Saransh-Gupta17/Bristol-SEDS-Rocketry-Simulation/CAD/Recovery system CAD/Recovery systems/Avionics bay.SLDPRT

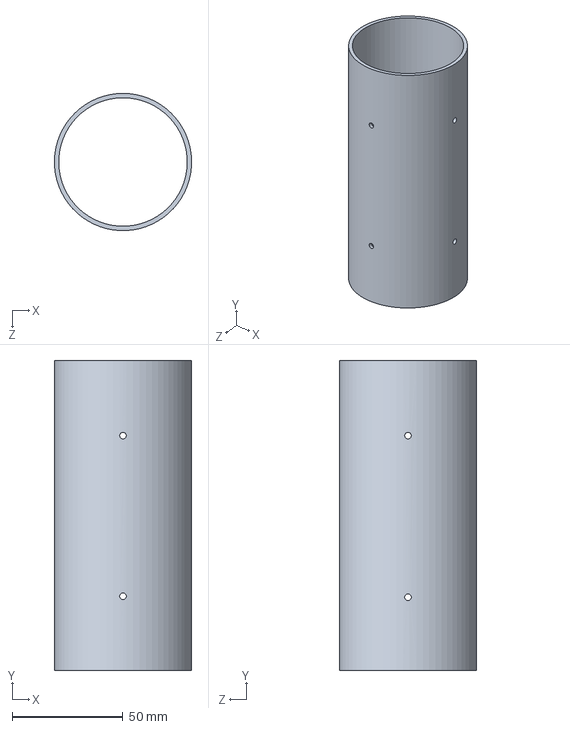
[picture p21: CAD file, 2026-06-27]
CAD/Recovery system CAD/Recovery systems/Avionics bay.SLDPRT
62.0 x 140.0 x 62.0 mm
