Saransh-Gupta17/Bristol-SEDS-Rocketry-Simulation/CAD/Recovery system CAD/Recovery systems/Forward buckhead.SLDPRT

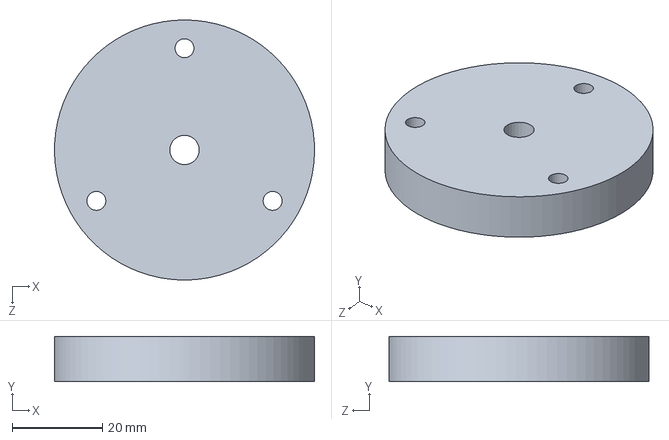
[picture p22: CAD file, 2026-06-27]
CAD/Recovery system CAD/Recovery systems/Forward buckhead.SLDPRT
57.5 x 10.0 x 57.5 mm
