Saransh-Gupta17/Bristol-SEDS-Rocketry-Simulation/CAD/Recovery system CAD/Recovery systems/Part file.STEP

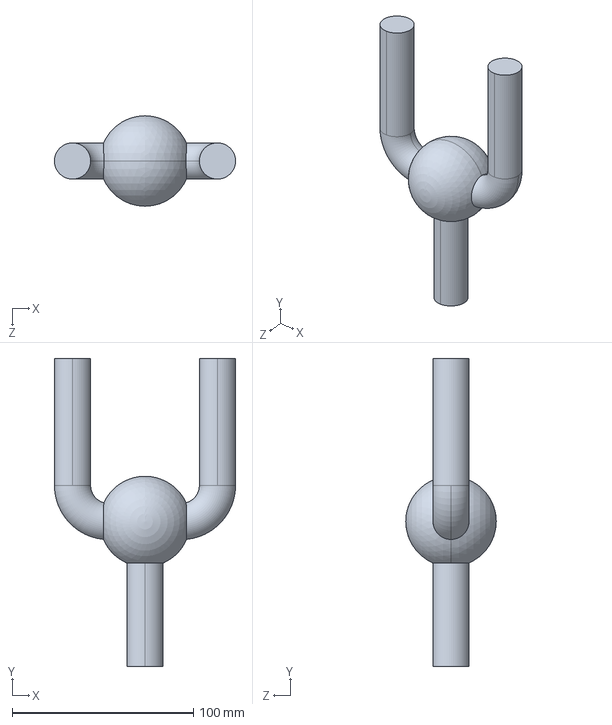
[picture p23: CAD file, 2026-06-27]
CAD/Recovery system CAD/Recovery systems/Part file.STEP
100.0 x 170.0 x 50.0 mm
