Saransh-Gupta17/Bristol-SEDS-Rocketry-Simulation/CAD/Recovery system CAD/Recovery systems/Avionics sled.SLDPRT

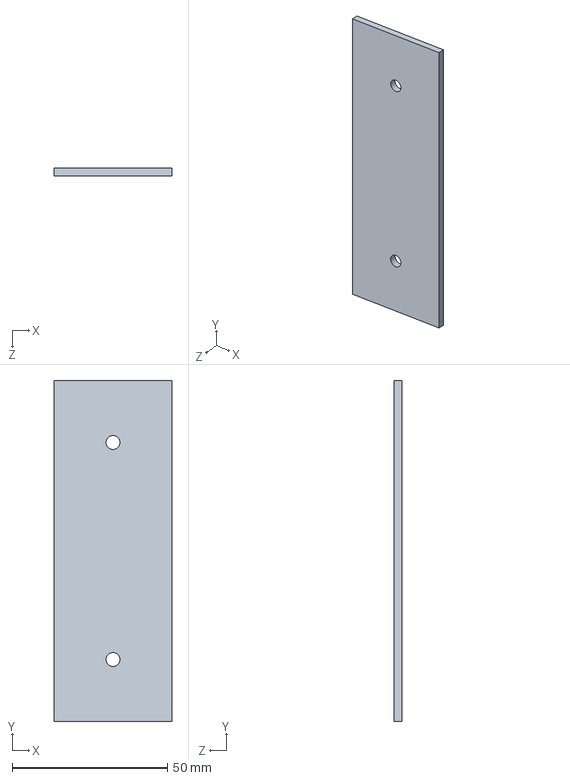
[picture p24: CAD file, 2026-06-27]
CAD/Recovery system CAD/Recovery systems/Avionics sled.SLDPRT
38.0 x 110.0 x 2.50 mm
