Saransh-Gupta17/Bristol-SEDS-Rocketry-Simulation/CAD/Recovery system CAD/Recovery systems/Washer.SLDPRT

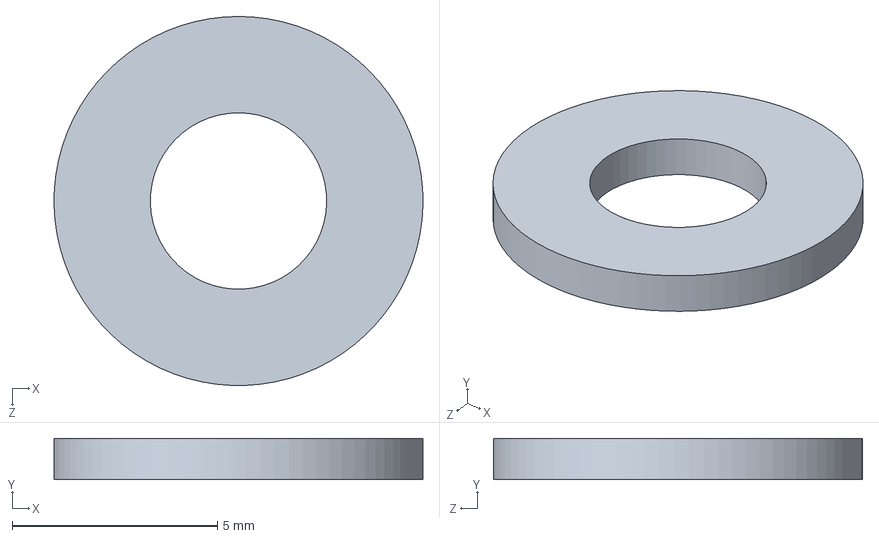
[picture p25: CAD file, 2026-06-27]
CAD/Recovery system CAD/Recovery systems/Washer.SLDPRT
9.00 x 1.00 x 9.00 mm
