Saransh-Gupta17/Bristol-SEDS-Rocketry-Simulation/CAD/Recovery system CAD/Recovery systems/nut.SLDPRT

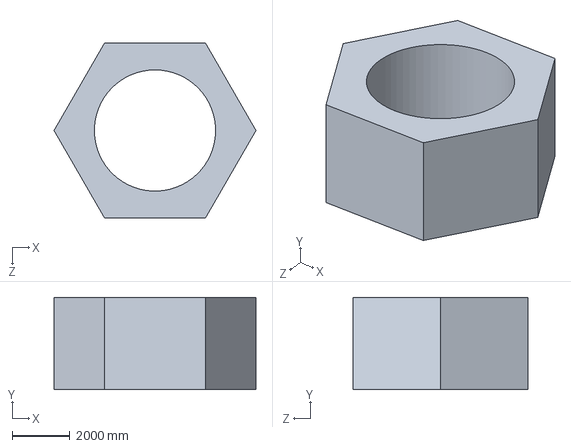
[picture p26: CAD file, 2026-06-27]
CAD/Recovery system CAD/Recovery systems/nut.SLDPRT
7000.0 x 3200.0 x 6062.2 mm
