Saransh-Gupta17/Bristol-SEDS-Rocketry-Simulation/CAD/Recovery system CAD/Recovery systems/Nut m4.SLDPRT

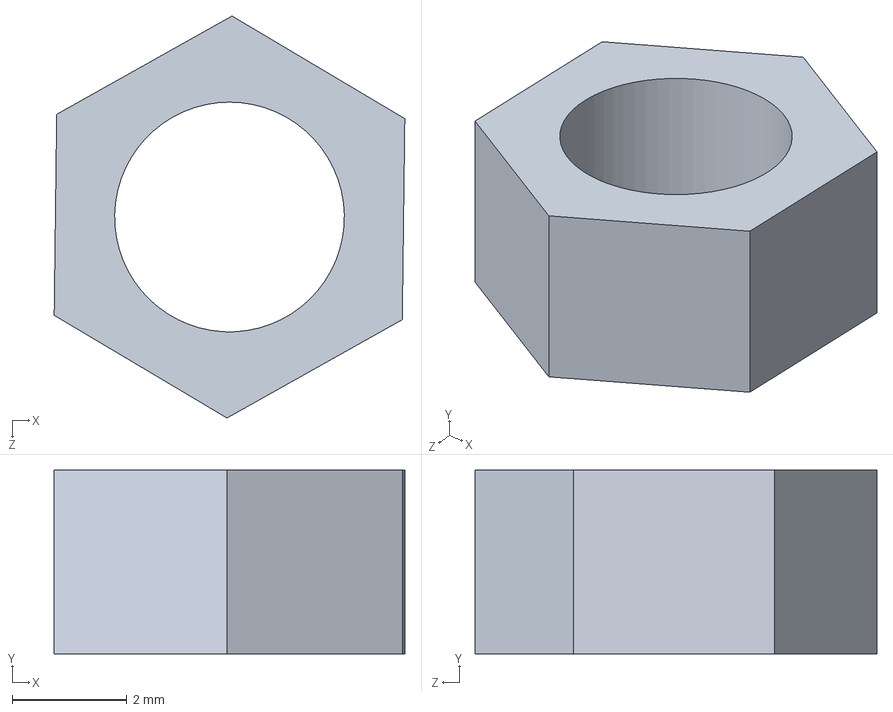
[picture p27: CAD file, 2026-06-27]
CAD/Recovery system CAD/Recovery systems/Nut m4.SLDPRT
6.11 x 3.20 x 7.00 mm
