Saransh-Gupta17/Bristol-SEDS-Rocketry-Simulation/(list of files, cad)

Other CAD files:
CAD/BRC fins.f3d
CAD/BRC tube coupler.f3d
CAD/Nosecone.f3d
CAD/SEDS rocket av holder.f3d
CAD/Upper and Lower Body Tube.f3d
